SorinoSSK/CNC-Clothes-To-Bag-Vending-Machine/Term 4 _ 30.007 _ Stitch/Machine System Sewing Mechanism/readme.md

## Decoupled CNC sewing mechanism
Initially, the team proposed a decoupled CNC sewing mechanism to undertake fabric sealing and it was constructed using components of an old mini sewing machine.
However, halfway through the project, the mechanism was abandoned due to design hiccups and limitations of the gantry. Sewing with a sewing machine components requires precise needle and bobbin alignment, which the gantry mechanism could not deliver. <br />
Our group have performed multiple testing and tuning, and we have narrowed it down to three issues. <br />
1) The needle hits the bobbin, causing both the needle and bobbin to jam.
<p align = "center">
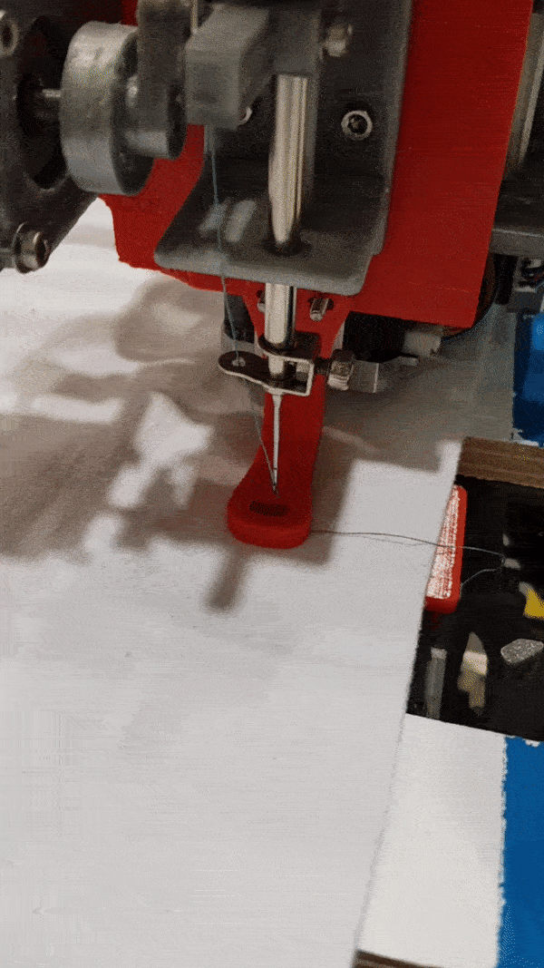
[picture p11: Resources/Hook Issue 2.gif]
  
  
2) The bobbin is too far from the needle causing the failure to hook the threads from the needle. <br />
<p align = "center">
  

3) The bobbin hits the needle causing the needle to bend and failure to hook the thread. The issue remains even when the needle's scarf is correctly positioned. <br />
<p align = "center">
  
  
The bending in the gantry triggers all three concerns, resulting in inaccuracy in the needle and bobbin alignment as it moves closer to the vending machine's center, circled in the image below.
<p align = "center">
    
  
Despite the failures, our team was able to consistently and successfuly achieve 2 stitches from the machine, proving the decoupled sewing mechanism's feasibility. Our group believes that a stronger gantry and a different bobbin hook mechanism (e.g. vertical rotation) will enhance the sewing mechanism's functionality.
<p align = "center">
