SorinoSSK/CNC-Clothes-To-Bag-Vending-Machine/Term 4 _ 30.007 _ Stitch/Machine System Sewing Mechanism/Finalised/readme.md

<h2> Success of Mechanism </h2>
<p>Here are some snippets of the heat sealing mechanism that underscores its success:</p>
