SorinoSSK/CNC-Clothes-To-Bag-Vending-Machine/Resources/InaccuracyZone.png

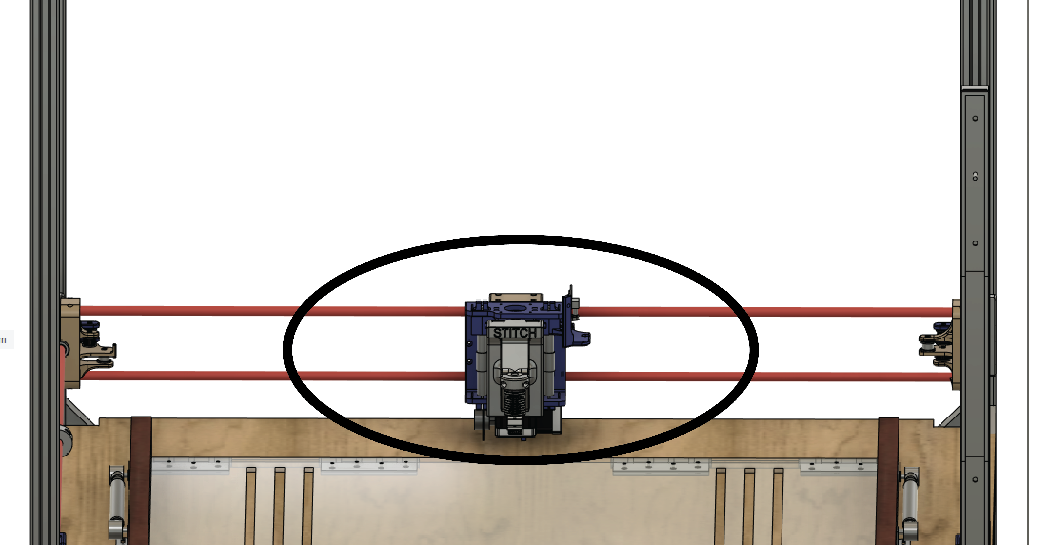
Resources/InaccuracyZone.png
