SorinoSSK/CNC-Clothes-To-Bag-Vending-Machine/Resources/Stitched.jpg

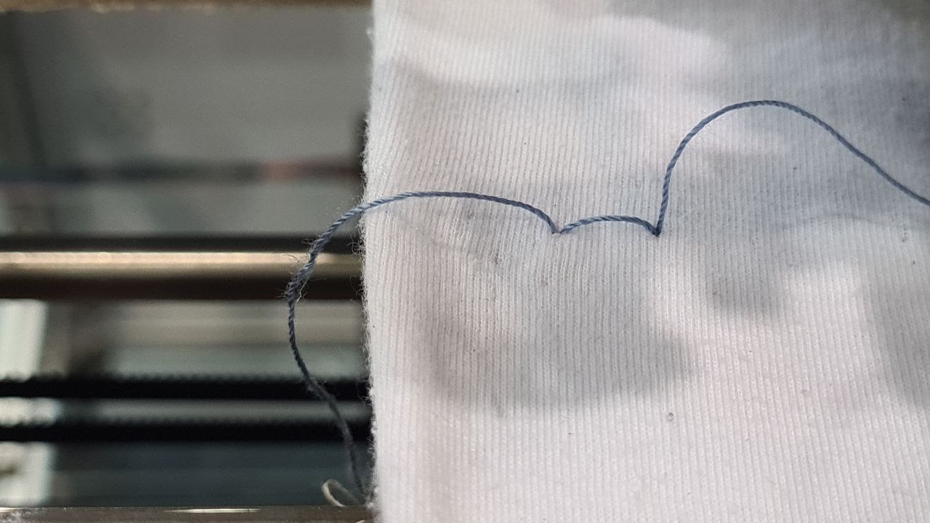
Resources/Stitched.jpg
