SorinoSSK/CNC-Clothes-To-Bag-Vending-Machine/Term 4 _ 30.007 _ Stitch/Machine System Heat Sealing Mechanism/Beta Version/Resistant.png

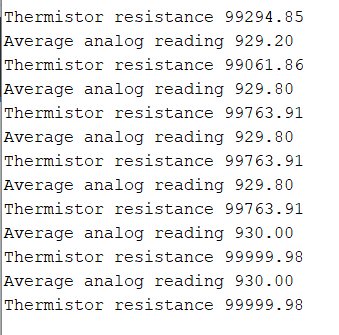
Term 4 _ 30.007 _ Stitch/Machine System Heat Sealing Mechanism/Beta Version/Resistant.png
