SorinoSSK/CNC-Clothes-To-Bag-Vending-Machine/(commit log)

2022-04-28 Rename Term 4 _ 30.007 _ Stitch/Machine_Code_V5/Machine_Code_V5.ino to Term 4 _ 30.007 _ Stitch/Machine System Heat Sealing Mechanism/Beta Version/Machine_Code_V5/Machine_Code_V5.ino
2022-04-28 Rename Term 4 _ 30.007 _ Stitch/Machine_Code_V7/Machine_Code_V7.ino to Term 4 _ 30.007 _ Stitch/Machine System Heat Sealing Mechanism/Beta Version/Machine_Code_V7/Machine_Code_V7.ino
2022-04-28 Rename Term 4 _ 30.007 _ Stitch/PID_TEMP_Test/PID_TEMP_Test.ino to Term 4 _ 30.007 _ Stitch/Machine System Heat Sealing Mechanism/Beta Version/PID_TEMP_Test/PID_TEMP_Test.ino
2022-04-28 Rename Term 4 _ 30.007 _ Stitch/Machine System Heat Sealing Mechanism/Machine_Code_V7/Machine_Code_V7.ino to Term 4 _ 30.007 _ Stitch/Machine System Heat Sealing Mechanism/Finalised/Machine_Code_V7/M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
